EzeMat21/Control-de-Velocidad-Motor-DC---Arduino/README.md

## Control de velocidad de un motor DC

Control PI simple discreto utilizando una placa Arduino, la planta corresponde a un puente H L298N y un motor DC.
Se utiliza el sensor de efecto hall AS5600 para determinar la velocidad.  
En la documentación se encuentra el informe detallado. 

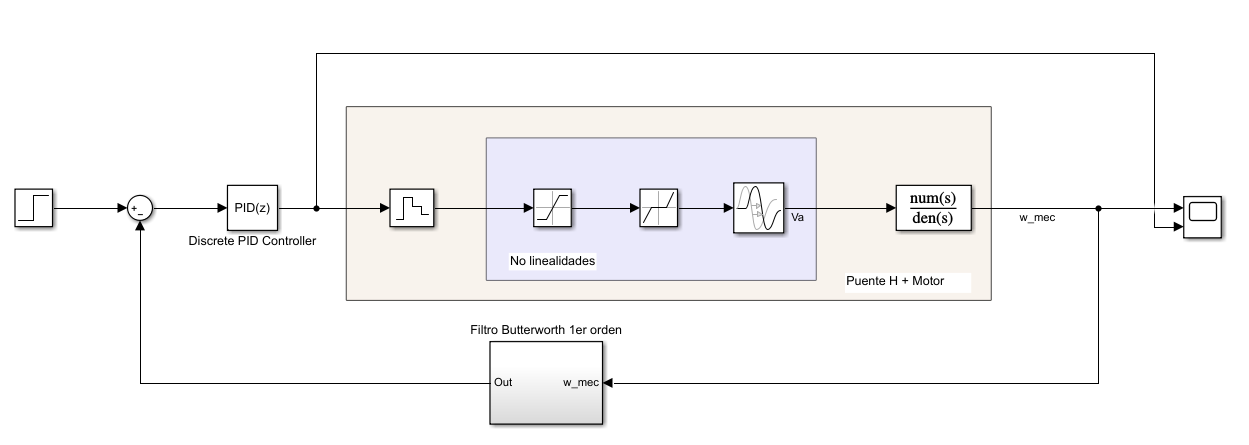
[picture p1: assets/lazo_figura.PNG]


### Respuesta al escalón utilizando un control PI

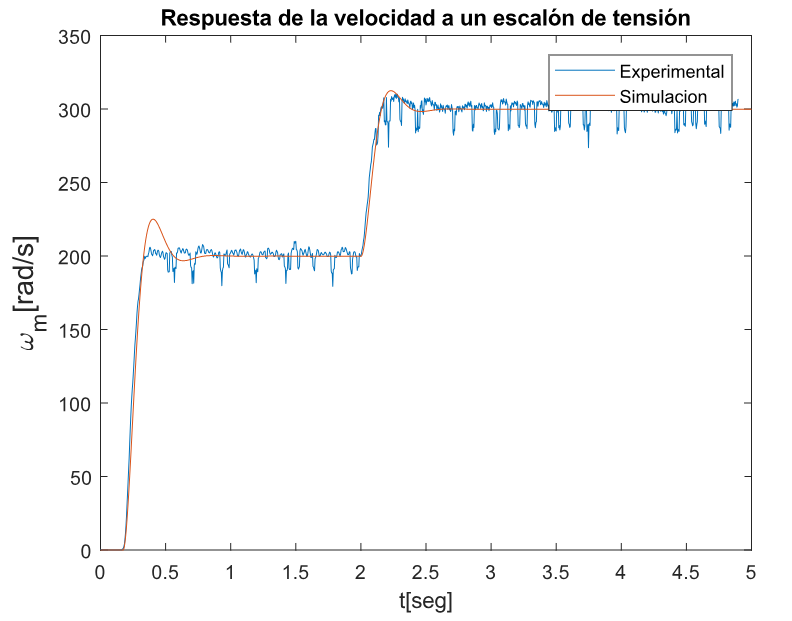
[picture p2: assets/rta_pi.PNG]
