EzeMat21/Control-de-Velocidad-Motor-DC---Arduino/Documentacion/Proyecto__Control_de_Velocidad_Motor_DC.pdf

# Proyecto: Control de Velocidad de un Motor DC

Ezequiel Matsuo

Septiembre 2025

## Índice

1. Introducción | 1
2. Modelo matemático de un motor DC | 1
3. Componentes utilizados | 2
4. Identificación del sistema | 2
5. Diseño del controlador | 5
6. Conclusiones | 9

## 1. Introducción

El proyecto consiste en realizar la identificación y posterior control de velocidad de un motor DC a través de un convertidor puente H. El objetivo es poder aplicar y poner en práctica el diseño de un controlador en una planta real.
La idea es realizar un modelo simple del sistema completo para no complejizar luego el diseño del controlador.

## 2. Modelo matemático de un motor DC

Se identifican dos ecuaciones diferenciales que modelan al motor de corriente continua: la parte eléctrica y la parte mecánica.

τm − τL = Jm

dωm
dt + Bωm | (1)
τm = KT ia | (2)

Va = iaRa + La

dia
dt + Ea | (3)
Ea = KEωm | (4)

Las ecuaciones 1 y 2 corresponden a la parte mecánica y las ecuaciones 3 y 4 a la parte eléctrica.
Para nuestro modelo matemático vamos a considerar las siguientes aproximaciones para simplificar las ecuaciones: asumir que la fricción viscosa B es despreciable y que la constante eléctrica es significativamente menor a la mecánica por lo que se asume que La = 0. En base a dichas consideraciones se aproxima al motor como un sistema de primer orden:
ωm
Va

=

1/KE
1 + sτm

(5)

Siendo τm = JRa/(KT KE).
Se agregarán luego no linealidades además de la transferencia anterior para mejorar el modelo del motor y el puente H.

## 3. Componentes utilizados

Tanto la medición de la velocidad del motor como el control se realizó a partir de una placa Arduino. Se utilizó el encoder de efecto hall AS5600 para medir las revoluciones del motor. Se utilizó la siguiente librería del sensor: https://github.com/RobTillaart/AS5600.
Para controlar el motor se utilizó el driver puente H L298N, donde es posible cambiar el sentido de giro a través de las entradas ’IN0’ e ’IN1’. Para controlar la tensión que excita al motor se utiliza una modulación PWM a través de la entrada ’ENA’ del modulo L298N.
Para obtener la velocidad angular del motor a partir del encoder se debe calcular la diferencia de las posiciones angular. Experimentalmente se vió que la máxima velocidad alcanzada para la máxima alimentación (19.5V) es de 3600rpm o 60 revoluciones por segundo. Como es necesario calcular la velocidad a partir de las posiciones angulares del encoder, se requiere que el sensor mida al menos cada 1/60 = 16,7ms ya que sino estaría perdiendose rotaciones. Experimentalmente se fijó el tiempo con interrupciones por Timer cada 4ms ya que se obtuvieron mejores resultados en la medición.

## 4. Identificación del sistema

### 4.1. Identificación de la Planta: Puente H + Motor

La identificación de los parámetros se hizo a lazo abierto utilizando la transferencia de primer orden de la ecuacion 5.
Se utilizó una interrupción por Timer2 para generar la medición de la velocidad y la acción de control. A su vez se utilizó el modulo Timer1 para generar la señal PWM que controla el puente H.
Se utilizó una frecuencia de 25kHz de forma que el motor trabaje en modo de conducción continua y la relación V a = DVcc sea válida, siendo V cc la tensión máxima de alimentación al puente H.
El ciclo de trabajo del PWM se controla a partir del registro OCR1A, siendo su valor máximo en registro de 639 para una frecuencia de 25kHz.
Para la identificación del sistema a lazo abierto se generaron escalones de tensión (para ser precisos, lo que se modifica es el ciclo de trabajo del PWM).

### 4.1.1. No linealidades + Sistema de 1er orden

El sistema completo del convertidor Puente H y el motor de continua se modeló de la siguiente manera: un sistema de primer orden con no linealidades de saturación, de zona muerta y un retardo, como se observa en el recuadro amarillo de la figura 4.
La no linealidad de saturación se agregó por el voltaje máximo que podía alcanzar el motor: 17V (el voltaje máximo de alimentación del convertidor es 19V pero se tiene en cuenta las caídas en los MOSFETs.)
La no linealidad de zona muerta se modeló en base a la curva mostrada en la figura 1, a partir de la observación de que existía un voltaje mínimo que el motor debía vencer para ponerse en funcionamiento. La ecuación de la recta queda expresada como:
ωm = 47,64(Va − 8,512) | (6)

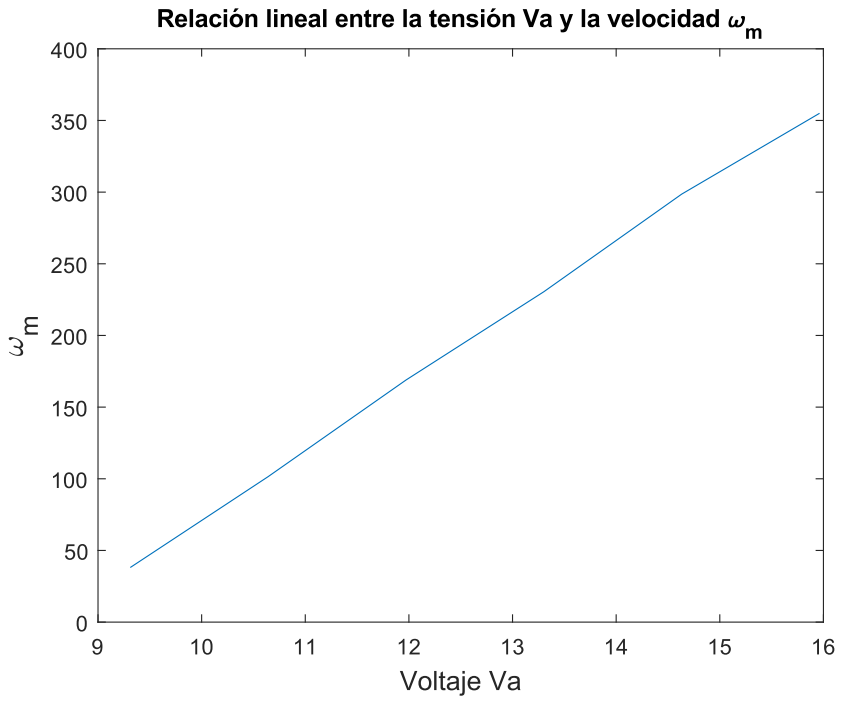
[picture p3: figure]

Figura 1: ωm vs Va

La recta anterior (ganancia mas offset) puede ser modelada como un sistema de primer orden y un bloque de zona muerta. Por tanto, la transferencia de primer orden que modela el motor queda identificada como:

ωm
Va

=

47,64
0,04s + 1

(7)

Mientras que la zona muerta se extiende dentro de −8,512 a 8,512. En la figura 2 se muestra la respuesta de velocidad a diferentes escalones de tensión del sistema identificado con las no linealidades y el sistema real sin filtro en el sensor de velocidad.

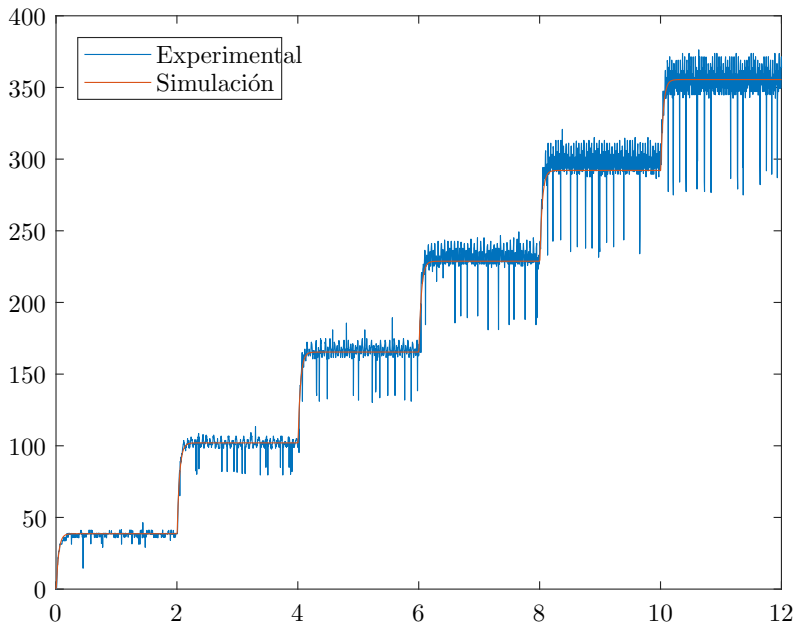
[picture p4: figure]
Experimental Simulación

Figura 2: Respuesta a escalones de tensión a lazo abierto

La idea fue tratar de modelar lo mejor posible el sistema a partir de bloques simples y no complejizarlo demasiado.
A partir de la identificación, podemos determinar los siguientes parámetros del motor:
Ra | 29 Ω
KE | 0,0209 (V · s)/rad
KT | 0,0209 (N · m)/A
Jm | 6,02 · 10⁻⁷ kg · m²

Cuadro 1: Parámetros Identificados

### 4.2. Filtrado del sensor

Los datos de velocidad se obtienen al calcular la diferencia entre posiciones angulares absolutas obtenidas del sensor AS5600, produciendo mediciones no precisas. Para ello se utilizaron diferentes filtros: dos promedios móviles de 2 y 4 muestras y un filtro IIR Butterworth de 1er orden, como se observan en la figura 3.

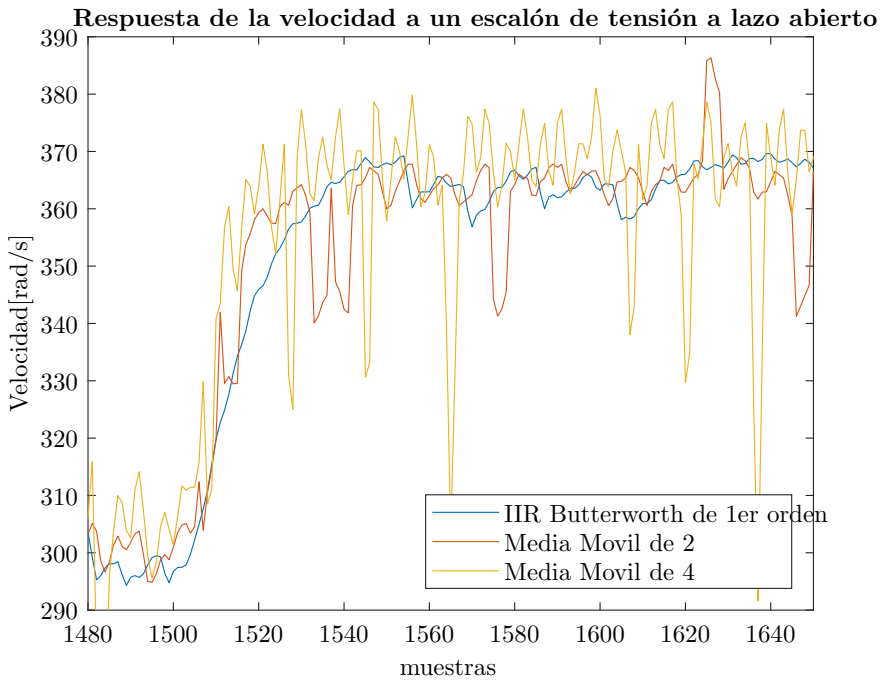
[picture p5: figure]
muestras; Velocidad[rad/s]; IIR Butterworth de 1er orden Media Movil de 2 Media Movil de 4

Respuesta de la velocidad a un escalón de tensión a lazo abierto

Figura 3: Comparativa entre los diferentes filtros

Se puede apreciar que el que mejor filtrado produce es el filtro Butterworth; sin embargo este filtro tiene la desventaja que genera un desfasaje no lineal de la fase e introduce un mayor retardo con respecto a los otros filtros. Como la distorsión en la respuesta no es tan evidente, se terminó utilizando el filtro Butterworth. Se eligió un filtro de 1er orden para no complejizar la transferencia del sistema. Por tanto, teniendo en cuenta que la frecuencia de muestreo es T s = 4ms y definiendo una frecuencia de corte del filtro pasabajos f c = 10Hz, se obtuvo la siguiente transferencia del filtro Butterworth en el dominio discreto:

Y (z)
X(z)

=

0,1122 + 0,1122z

−1
1 − 0,7757z⁻¹

(8)

## 5. Diseño del controlador

A partir de la identificación del modelo se obtuvo una constante de tiempo τm = 40ms.
De esta forma si consideramos una frecuencia de muestreo 10 veces más rápido que la frecuencia de corte del sistema se tiene una cota dada por ts ≤ 4ms. Por tanto, se difinió que la acción de control va a actuar cada 4ms.
Se analizarán dos controladores: uno proporcional y otro proporcional-integral. Para ambos casos no tendremos en cuenta las no linealidades de saturación y zona muerta para el diseño del controlador. Sin embargo, sí se considerará el retardo z

−1
en la transferencia del sistema asi como el retenedor de orden cero que modela el valor medio del PWM que sale del microcontrolador. Por tanto, para ambos diseños se tendrá en cuenta que la transferencia de la planta es:

G(z) = Z{¹ − e

T s
s

K
sτm + 1

}z

−1 = K(1 − z

−1
)
1
1 − z⁻¹

−

τm
1 − e⁻T /τmz⁻¹
z

−1
(9)

El término Z{¹ − e

T s
s

K
sτm + 1

} corresponde a la transformada Z de la función pulso del retenedor de orden

cero y la transferencia de primer orden. Teniendo en cuenta que la constante de tiempo τm = 40ms y el tiempo de muestreo es T = 4ms, se obtiene la transferencia con los siguientes valores:

G(z) = 47,64
0,96 − 0,8648z

−1
1 − 0,9048z⁻¹
z

−1

En base al lazo cerrado mostrado en la figura 4 y teniendo en cuenta un controlador C(z), tendremos la siguiente transferencia a lazo cerrado:

Ω(z)
R(z)

=

C(z)G(z)
1 + C(z)G(z)H(z)

(10)

Donde Ω(z) es la transformada Z de la velocidad, R(z) el de la referencia y H(z) corresponde al filtro Butterworth de la ecuación 8.


Figura 4: Diagrama del lazo cerrado en Simulink

### 5.1. Controlador PI

### 5.1.1. Lugar de Raíces

Se diseñó un controlador PI digital con la siguiente expresion:

C(s) = Kp(1 + I · Ts
z − 1
) | (11)

Donde Kp es la ganancia proporcional, I la constante de la integral y Ts el periodo de muestreo. La ecuación característica está dado por:

C(z)G(z)H(z) = −1 | (12)

Para simplificar los cálculos, como el cero y el polo de la transferencia de G(z) están muy próximos entre sí, vamos a considerar que ambos se cancelan. De modo que la ecuación característica se aproximará a la siguiente:

C(z)G(z)H(z) ≈ 47,64 · Kp(

z − 1 + I · Ts
z − 1

)

(0,1122 + 0,1122z

−1
)
(1 − 0,7757z⁻¹)

z

−1
| (13)

Para el diseño del controlador aproximaremos nuestreo sistema a uno de segundo orden, de manera que definiremos como parámetros de diseño al factor de amortiguamiento ξ y la pulsación angular natural ωn. De esta manera podemos expresar el tiempo de establecimiento y la máxima sobrelongación a partir de los parámetros anteriores.
El tiempo de establecimiento para un sistema de 2do orden con subamortiguamiento (0 < ξ < 1) esta dado por:

ts =

4
ξωo

En tanto la máxima sobreelongación Mp como:

Mp = exp(−πξ/p
1 − ξ

2)

Si definimos un tiempo de establecimiento de unos 100ms y una sobreelogación máxima de 1 %, tendremos los siguientes valores: ξ = 0,82 y ωn = 48rad/s. Esto correspondería a unos polos complejos conjugados en el plano s de s1,2 = ξωn ± ωn

p
1 − ξ

2 = −39,6 ± 28j.
Para pasar al plano discreto, se cumple que e

sT , de modo que los polos complejos se mapean al plano discreto como: z1,2 = 0,8468 + 0,095j.
En base a la condición de ángulo del lugar de raíces, se obtiene que el cero del controlador debe aportar unos
25. De modo que la constante integral I se obtiene de la siguiente ecuación.

θ = tan⁻¹

0,095
0,8468 + 1 − I · Ts
(14)

Por consiguiente tenemos que I = 410 y a partir de la condición de magnitud se obtiene que la constante proporcional del controlador debe ser Kp = 0,00123.

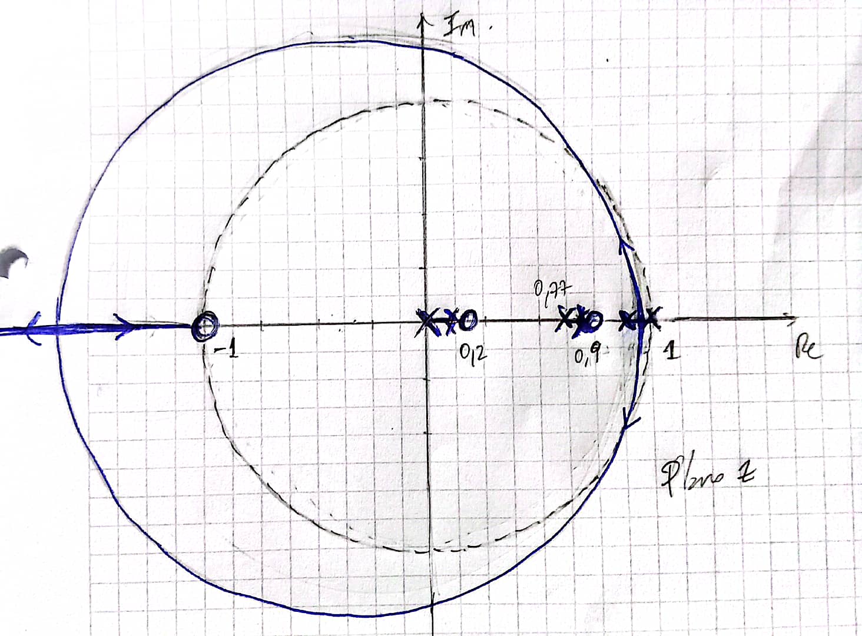
[picture p6: figure]

Figura 5: Lugar de Raices para el sistema con control PI

En la figura 5 se observa el lugar de raíces de la ecuación característica. Se observa que tenemos 4 polos y 3 ceros, por tanto tendremos una sola asíntota: el eje real. Se observa como los polos en 1 y 0.9048 se dirigen hacia el cero en -1 y hacia −∞ en el eje real. Luego los demás polos se dirigen hacia el cero más cercano. Se puede calcular que el sistema se inestabiliza para un valor de Kp = 0,08.

### 5.1.2. Resultados experimentales

A partir de las simulaciones se vió que la máxima sobreelongación sobrepasaba el valor inicial calculado por lo que se modificó a la mitad la constante integral I. Esta diferencia entre los valores calculados y la simulación de la planta completa se deben a los siguientes puntos: se simplificó la ecuación característica del sistema (ignorando el cero y polo de G(z)) y los parámetros ξ y ωn corresponden a parámetros de un sistema de 2do orden, cuando el nuestro corresponde a 2 ceros y 4 polos.
Por consiguiente, los valores del controlador PI discreto quedaron definidos como I = 200 y Kp = 0,00123. En la figura 6 se observa la respuesta a escalones de referencia de 0 a 200rad/s en el tiempo t = 0s y de

200rad/s a 300rad/s en el tiempo t = 2s. La velocidad experimental de la figura 6 se filtró de forma ’offline’, la velocidad real posee más ruido. Como el encoder utilizado es uno de posición, para obtener las velocidades se tiene que calcular la diferencia entre posiciones. Este ruido no afecta la respuesta del sistema ya que existe un filtro en la realimentación y como se observa en la acción de control (Figura 7) no se ve excitado por las

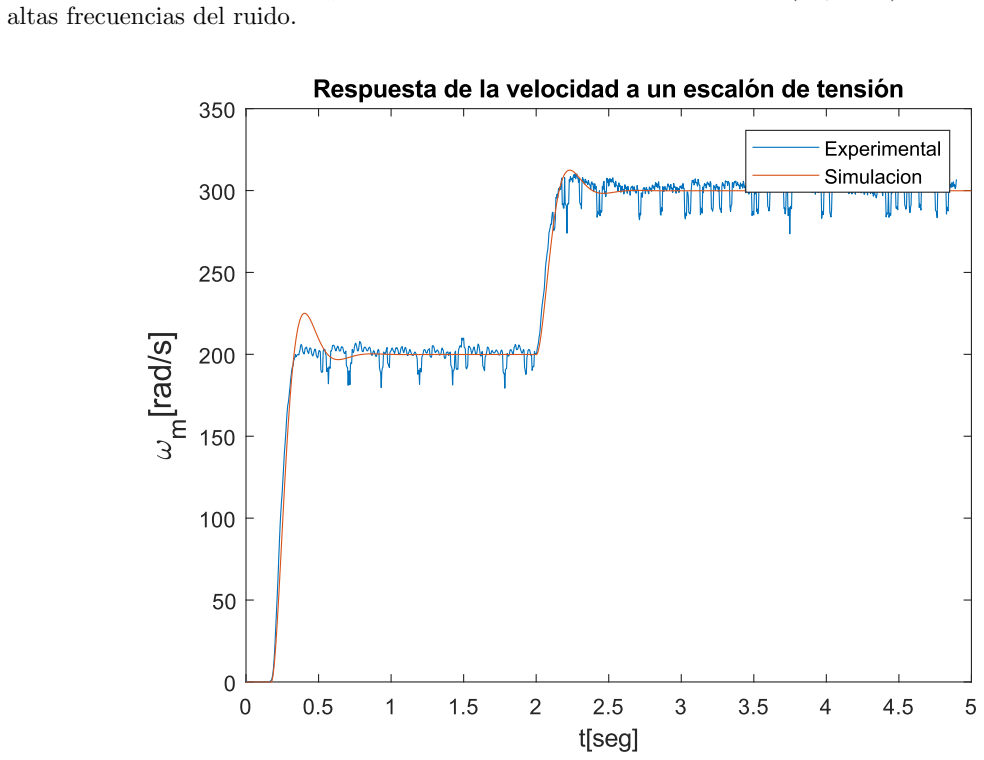
[picture p7: figure]
altas frecuencias del ruido.

Figura 6: Respuesta a escalones de referencia con I = 200 y Kp = 0,00123. La respuesta se filtró de forma offline debido al ruido del sensor. Este ruido del sensor no afecta la acción de control.

0 | 0.5 | 1 | 1.5 | 2 | 2.5 | 3 | 3.5 | 4 | 4.5 | 5
| | | | | t[seg]

0

5

10

15

Va[V]

Acción de control u

Figura 7: Acción de control experimental

## 6. Conclusiones

Lo más complicado de este proyecto fue la correcta identificación del sistema, ya que se tuvieron que añadir no linealidades (zona muerta, saturación y retardo) que no se habían tenido en cuenta en un inicio.
Otro de los puntos importantes a tener en cuenta en el control de este sistema fue el correcto filtrado de la velocidad mecánica debido a que se utiliza un encoder de posición. Se tiene que realizar una diferencia para obtener la medición, por lo que de esta manera existe mucho ruido. Para ello se optó por un filtro Butterworth debido a que es simple y con un menor orden, donde se obtuvieron buenos resultados.
En un futuro, se analizarán otras acciones de control, como una realimentación de estados, para realizar comparaciones entre ellas
