EzeMat21/Control-de-Velocidad-Motor-DC---Arduino/(commit log)

2025-09-19 se ignora el achivo .txt de dco
2025-09-19 se agrega el informe
2025-09-19 se agrega el doc
2025-09-19 se deja de trackear el .txt
2025-09-19 se modifica el readme
2025-09-19 se modifica el readmee
2025-09-28 se agrega la carpeta assets
